little-scale/Tele-o-Module/README.md

# Tele-o-Module
Eurorack Module for WiFi / BlueTooth / BLE to 4 CV and 2 Gates
