little-scale/Tele-o-Module/hardware/faceplace_form.dxf

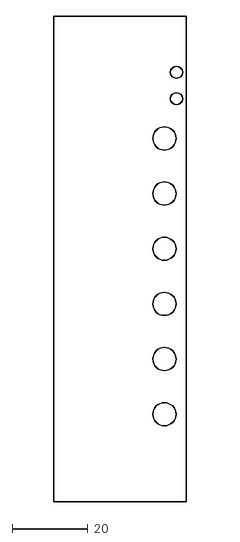
[picture p1: CAD file, 2023-01-30]
hardware/faceplace_form.dxf
35.0 x 128.5
