little-scale/Tele-o-Module/hardware/BLE_Module_Front_Board.kicad_pcb

## KiCad design hardware/BLE_Module_Front_Board.kicad_pcb (2023-01-30)

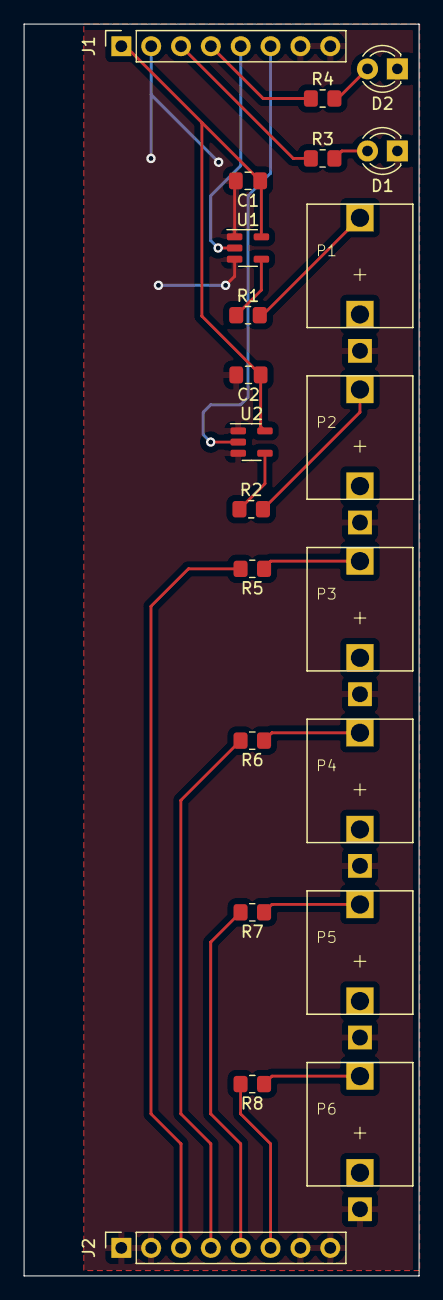
[picture p2: board BLE_Module_Front_Board.kicad_pcb from above]

Board: 2 copper layers, 33.6 x 106.5 mm, 22 parts (0 on the bottom side), 20 nets.

Parts:
C1, C2: C; C_0805_2012Metric_Pad1.18x1.45mm_HandSolder
D1, D2: LED; LED_D3.0mm
J1, J2: Conn_01x08_Male; PinSocket_1x08_P2.54mm_Vertical
P1, P2, P3, P4, P5, P6: EuroCon; THONKICONN
R1, R2, R3, R4: 1k; R_0805_2012Metric_Pad1.20x1.40mm_HandSolder
R5, R6, R7, R8: 1K; R_0805_2012Metric_Pad1.20x1.40mm_HandSolder
U1, U2: 74AHCT1G125; SOT-23-5

Connections:
+5V: C1.1, C2.1, J1.1, U1.5 (VCC), U2.5 (VCC)
/CV1: J2.3, R5.2
/CV2: J2.4, R6.2
/CV3: J2.5, R7.2
/CV4: J2.6, R8.2
/GATE1: J1.5, U1.2
/GATE2: J1.6, U2.2
/LED1: J1.3, R3.1
/LED2: J1.4, R4.1
GND: C1.2, C2.2, D1.1 (K), D2.1 (K), J1.2, J1.7, J1.8, J2.1, J2.2, J2.7, J2.8, P1.P$1_SLEEVE, P2.P$1_SLEEVE, P3.P$1_SLEEVE, P4.P$1_SLEEVE, P5.P$1_SLEEVE, P6.P$1_SLEEVE, U1.1, U1.3 (GND), U2.1, U2.3 (GND)
unnamed: D1.2 (A), R3.2
unnamed: D2.2 (A), R4.2
unnamed: P1.P$3_TIP, R1.2
unnamed: P2.P$3_TIP, R2.2
unnamed: P3.P$3_TIP, R5.1
unnamed: P4.P$3_TIP, R6.1
unnamed: P5.P$3_TIP, R7.1
unnamed: P6.P$3_TIP, R8.1
unnamed: R1.1, U1.4
unnamed: R2.1, U2.4
