little-scale/Tele-o-Module/hardware/BLE_Module.kicad_pcb

## KiCad design hardware/BLE_Module.kicad_pcb (2023-01-30)

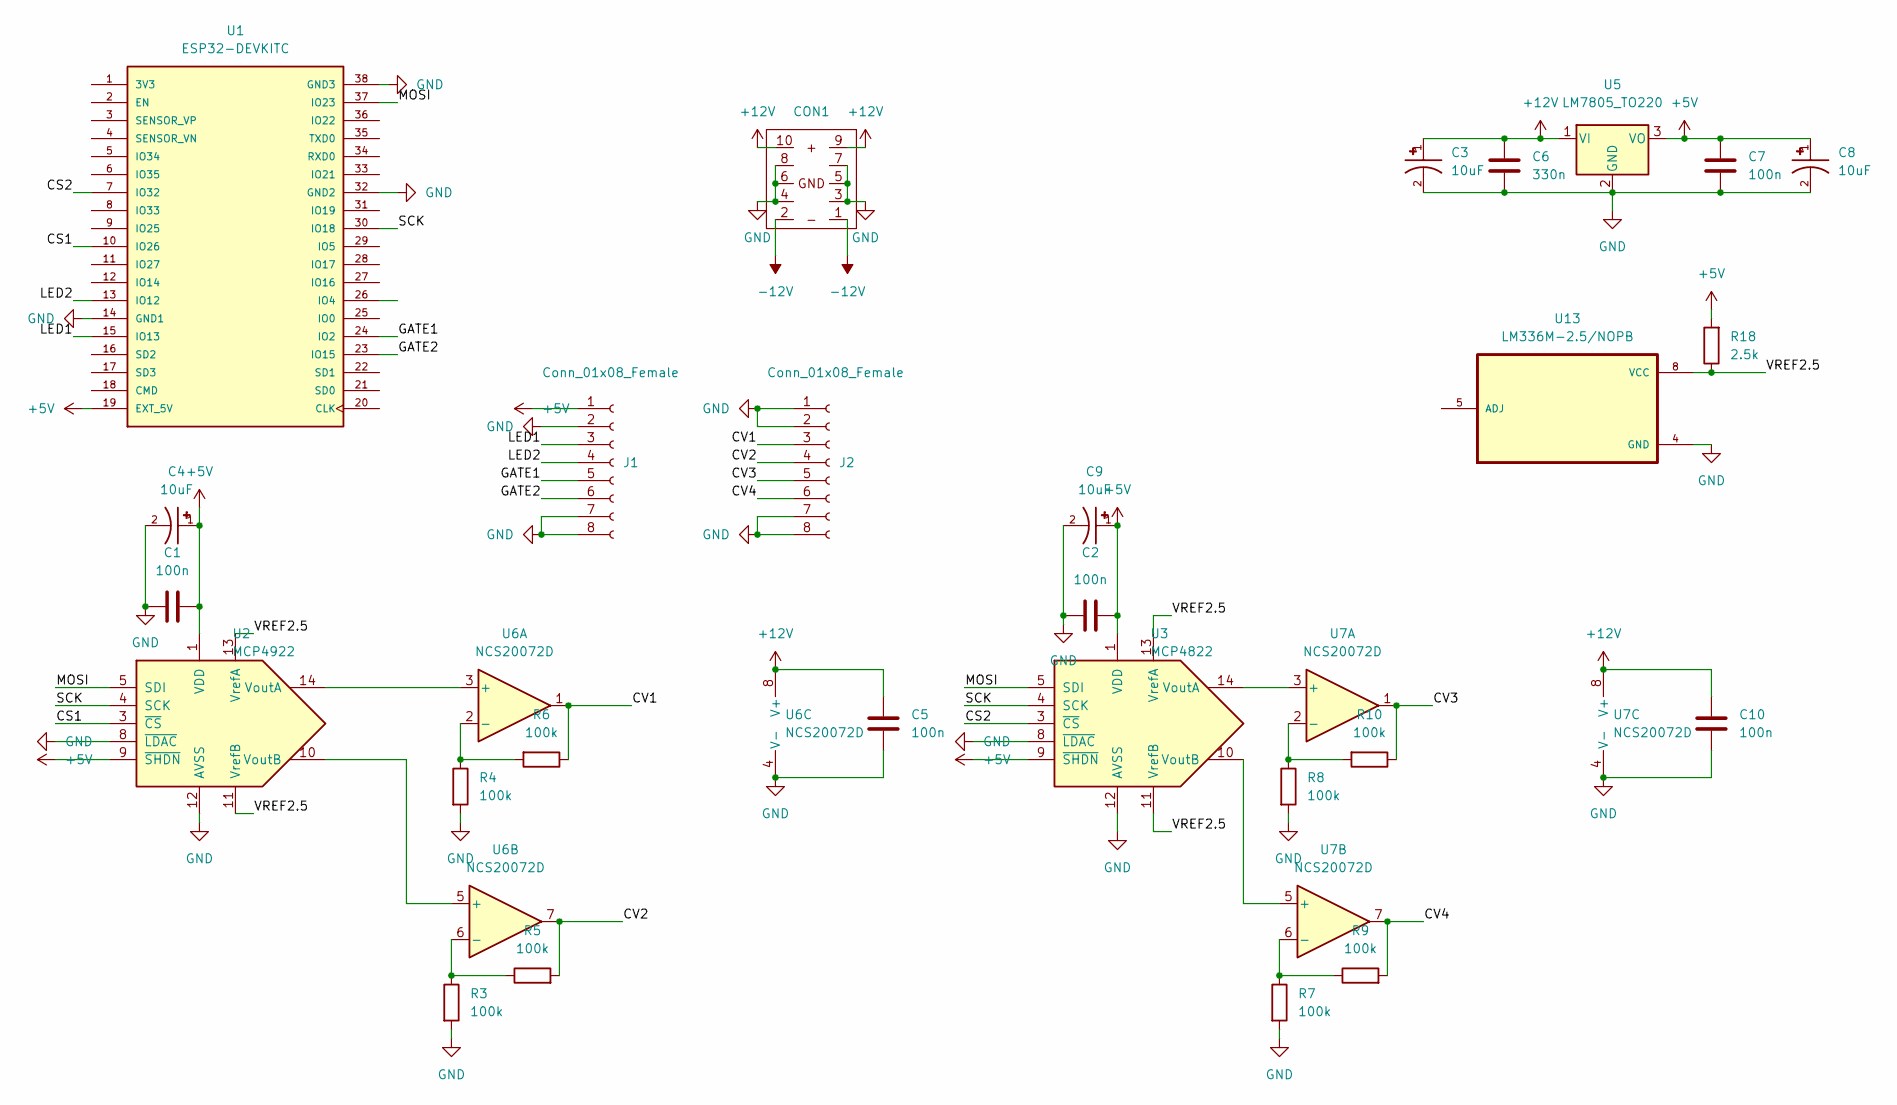
[picture p3: schematic BLE_Module.kicad_sch]

Parts:
C1, C2, C5, C7, C10: 100n; C_0805_2012Metric_Pad1.18x1.45mm_HandSolder
C3, C4, C8, C9: 10uF; CAP_EEEFN1E100R; PARTREV 10-Oct-19
C6: 330n; C_0805_2012Metric_Pad1.18x1.45mm_HandSolder
CON1: EuroPow; EURO_POWER_HEADER
J1, J2: Conn_01x08_Female; PinSocket_1x08_P2.54mm_Vertical
R3, R4, R5, R6, R7, R8, R9, R10: 100k; R_0805_2012Metric_Pad1.20x1.40mm_HandSolder
R18: 2.5k; R_0805_2012Metric_Pad1.20x1.40mm_HandSolder
U1: ESP32-DEVKITC; MODULE_ESP32-DEVKITC; PARTREV N/A
U2: MCP4922; SOIC127P600X175-14N
U3: MCP4822; SOIC127P600X175-14N
U5: LM7805_TO220; TO-220-3_Vertical
U6, U7: NCS20072D; SOIC-8_3.9x4.9mm_P1.27mm
U13: LM336M-2.5/NOPB; SOIC127P599X175-8N

Connections:
+5V: C1.2, C2.2, C4.1, C7.1, C8.1, C9.1, J1.1, R18.2, U1.19 (EXT_5V), U2.1 (VDD), U2.9 (~SHDN), U3.1 (VDD), U3.9 (~SHDN), U5.3 (VO)
+12V: C3.1, C5.1, C6.1, C10.1, CON1.9, CON1.10, U5.1 (VI), U6.8 (V+), U7.8 (V+)
-12V: CON1.1, CON1.2
/CS1: U1.10 (IO26), U2.3 (~CS)
/CS2: U1.7 (IO32), U3.3 (~CS)
/CV1: J2.3, R6.1, U6.1
/CV2: J2.4, R5.2, U6.7
/CV3: J2.5, R10.1, U7.1
/CV4: J2.6, R9.2, U7.7
/GATE1: J1.5, U1.24 (IO2)
/GATE2: J1.6, U1.23 (IO15)
/LED1: J1.3, U1.15 (IO13)
/LED2: J1.4, U1.13 (IO12)
/MOSI: U1.37 (IO23), U2.5 (SDI), U3.5 (SDI)
/SCK: U1.30 (IO18), U2.4 (SCK), U3.4 (SCK)
/VREF2.5: R18.1, U2.11 (VrefB), U2.13 (VrefA), U3.11 (VrefB), U3.13 (VrefA), U13.8 (VCC)
GND: C1.1, C2.1, C3.2, C4.2, C5.2, C6.2, C7.2, C8.2, C9.2, C10.2, CON1.3, CON1.4, CON1.5, CON1.6, CON1.7, CON1.8, J1.2, J1.7, J1.8, J2.1, J2.2, J2.7, J2.8, R3.2, R4.2, R7.2, R8.2, U1.14 (GND1), U1.32 (GND2), U1.38 (GND3), U2.8 (~LDAC), U2.12 (AVSS), U3.8 (~LDAC), U3.12 (AVSS), U5.2 (GND), U6.4 (V-), U7.4 (V-), U13.4 (GND)
unnamed: R3.1, R5.1, U6.6 (-)
unnamed: R4.1, R6.2, U6.2 (-)
unnamed: R7.1, R9.1, U7.6 (-)
unnamed: R8.1, R10.2, U7.2 (-)
unnamed: U2.10 (VoutB), U6.5 (+)
unnamed: U2.14 (VoutA), U6.3 (+)
unnamed: U3.10 (VoutB), U7.5 (+)
unnamed: U3.14 (VoutA), U7.3 (+)

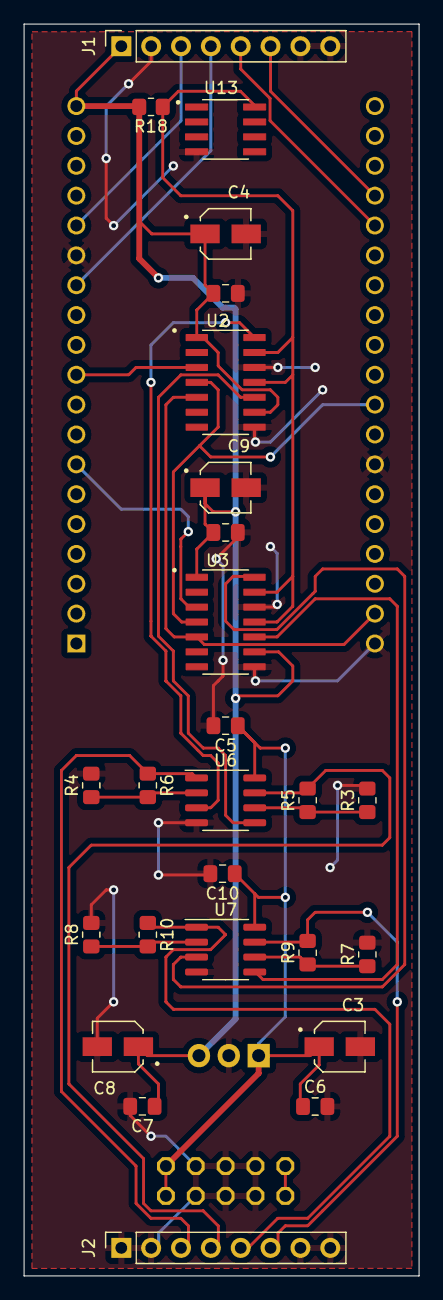
[picture p4: board BLE_Module.kicad_pcb from above]

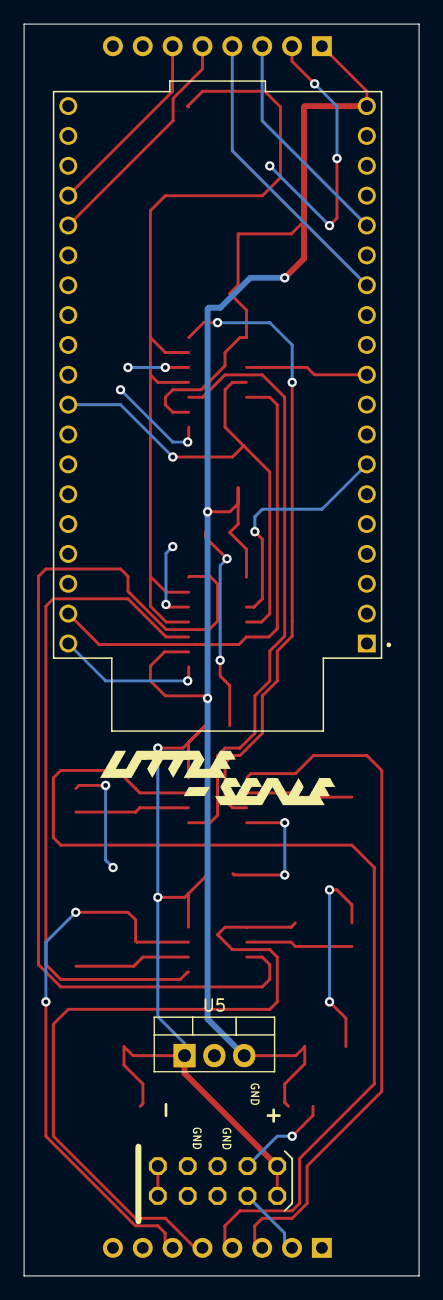
[picture p5: board BLE_Module.kicad_pcb from below]

Board: 2 copper layers, 33.6 x 106.5 mm, 29 parts (3 on the bottom side), 25 nets.
